Glenn-IT/PCBCES-Plastic-Bottle-Coin-Exchanger-System/docs/chassis_design.html

Mechanical & Industrial Design Specifications

# PCBCES Machine Chassis Concept & Blueprint

Full 3D visualization, internal cutaway anatomy, structural frame blueprint, and fabrication specifications for the Plastic Bottle Coin Exchanger Reverse Vending Kiosk.

← Back to System Hub Electrical Wiring Guide Project Plan Document Arduino Test Suite

🔥

## Machine Visual Presentations & 3D Concepts

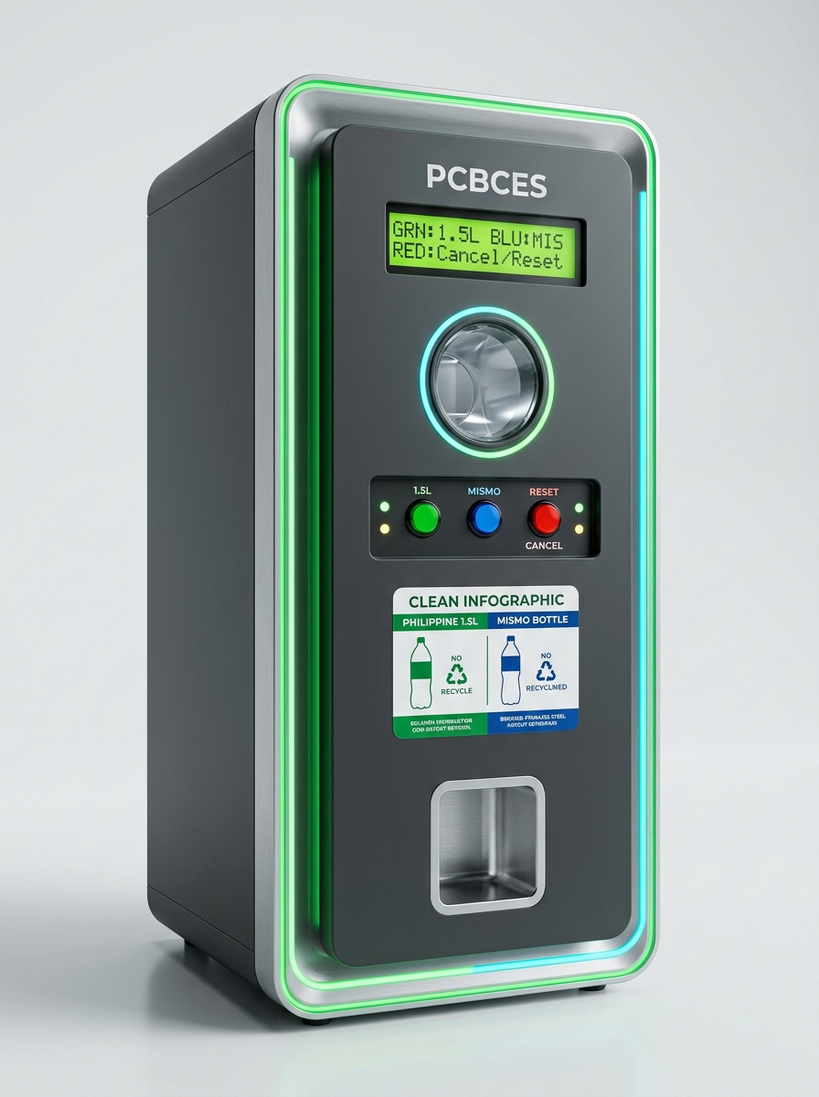
[picture p1: docs/images/pcbces_kiosk_3buttons_1788550020043.jpg]
PCBCES Kiosk Exterior 3-Button Render
Finished Aesthetic (3-Button UI) 

1. Exterior Kiosk Enclosure

Sleek freestanding smart recycling kiosk with dual-tone matte charcoal and brushed aluminum finish. Fitted with eco-friendly LED ring indicators, user prompt screen, and coin retrieval receptacle.

- Overall Size: 120cm (H) × 50cm (W) × 45cm (D)
- Display: 16×2 I2C Backlit LCD Screen
- Input Control: 3× Dedicated Buttons (Green: 1.5L, Blue: Mismo, Red: Reset)
- Intake Ring: 110mm Circular Transparent Port
- Payout Port: Stainless Steel Coin Well

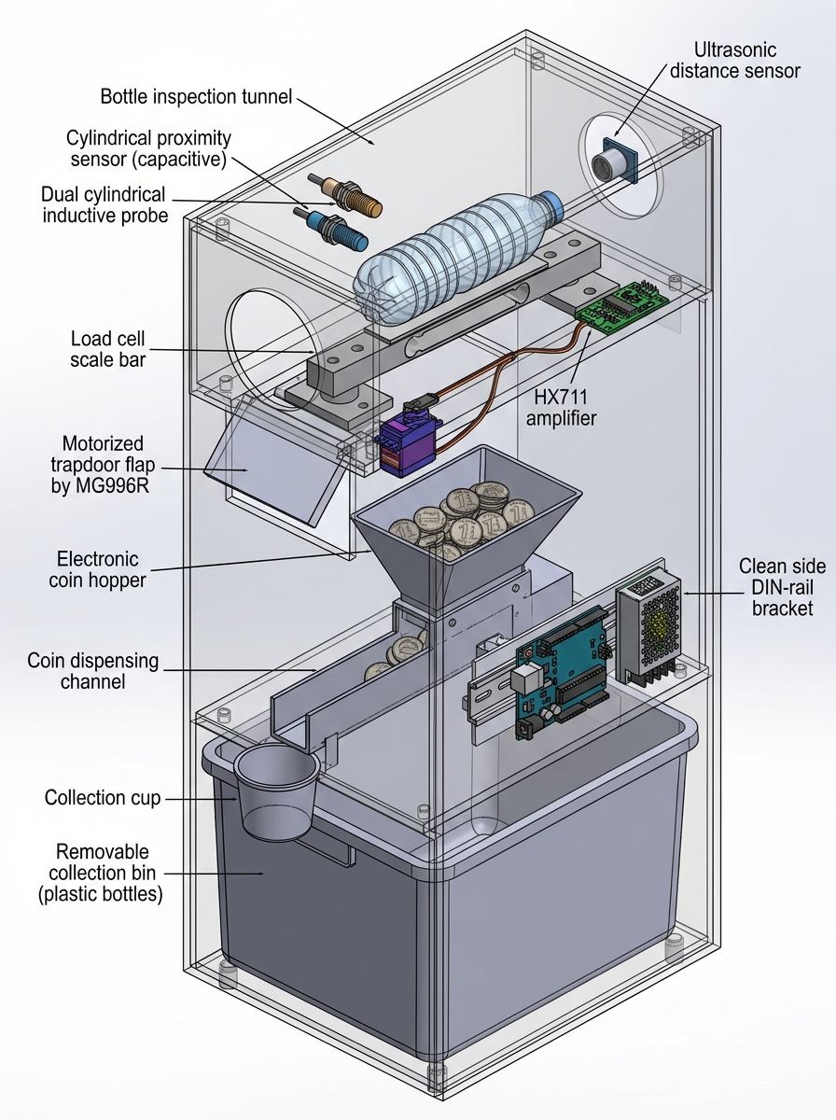
[picture p2: docs/images/pcbces_chassis_cutaway_1788544580664.jpg]
PCBCES Chassis Cutaway Internal Mechanical View
Internal Anatomy 

2. Internal Mechanical Cutaway

Transparent cross-section demonstrating the exact spatial placement of the rigid bottle cradle, non-contact proximity probes, ultrasonic length sensor, MG996R servo trapdoor flap, 12V coin hopper, and controller board.

- Upper Chamber: Non-Contact Sensor Cradle (Length, Metal, Plastic)
- Sorting Flap: MG996R 180° High-Torque Servo Trapdoor
- Coin Dispenser: 12V Motorized Coin Hopper (₱1 Coins)
- Controller: Arduino Uno + LM2596 5V/4V Buck
- Lower Chamber: 30-Bottle High-Capacity Removable Bin

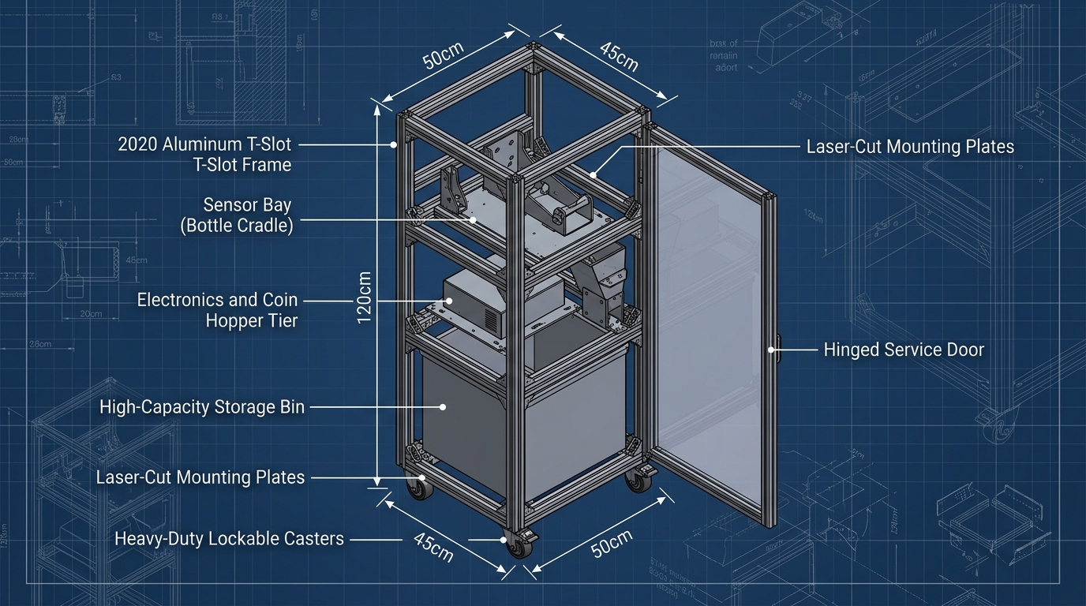
[picture p3: docs/images/pcbces_chassis_frame_1788544600156.jpg]
PCBCES Chassis Frame Blueprint
Structural CAD 

3. Structural Frame & Blueprint

Modular 2020 aluminum T-slot extrusion frame blueprint with laser-cut mounting plates, lockable swivel caster wheels, and front hinged maintenance service door with key cam lock.

- Frame Material: 2020 Aluminum T-Slot / 1/2" Marine Plywood
- Service Access: Full-Height Front Hinged Door
- Mobility: 4× 2-inch Lockable Swivel Casters
- Modular Shelves: 3-Tier Separation Plates
- Cable Trays: Rear Slotted Wire Ducting

📦

## Modular 3-Tier Chassis Architecture

Tier 1 • Top Level (Height: 80cm – 120cm)

### Bottle Inspection Cradle & User Interface

Ergonomically positioned at natural waist-to-chest level for intuitive user operation and clear visibility of the 16×2 instruction screen.

- Bottle Chamber: 43cm vertical chamber with entry guide to support upright bottle placement on the trapdoor.
- Rigid Cradle Mount: Bolted directly to shelf frame with zero fragile deflection points, eliminating mechanical fatigue.
- Proximity Probe: LJ12A3 (Inductive metal sensor) mounted along the chamber wall facing the bottle body for instant metallic object/can rejection. (LJC18A3 capacitive sensor omitted; D5 spare).
- HC-SR04 Ultrasonic: Mounted at the top ceiling (43cm above floor trapdoor) firing downward to measure ceiling-to-bottle cap distance (1.5L/1.7L: 7–15cm, Mismo: 20–27cm).
- MG996R Servo Flap: Bottom trapdoor flap under bottle base. Tilts 90° down to drop accepted bottle into lower bin, or remains closed at 0° for rejection retrieval.

Tier 2 • Mid Level (Height: 45cm – 80cm)

### Coin Hopper & Electronics Control Bay

Secure, dry compartment physically isolated from the bottle dropping path to protect sensitive electronics and coin inventory.

- 12V Coin Hopper: Bolted to mid-shelf with dedicated 45° smooth coin chute feeding down into front retrieval cup.
- Controller Board: Arduino Uno on DIN-rail or standoff mounts with quick-disconnect terminal blocks.
- Dual-Rail Power: S-120-12 (12V 10A PSU) + LM2596 buck converter supplying stable 5.0V (logic) and 4.0V (SIM800L).
- GSM SIM800L Bay: Positioned with external stub antenna away from power transformers to prevent RF noise.

Tier 3 • Base Level (Height: 0cm – 45cm)

### High-Capacity Bottle Collection Bin

Spacious, easily serviceable collection chamber designed to store up to 30–50 empty plastic bottles before requiring emptying.

- Removable Tub: Standard 50-liter plastic tote container with integrated side handles for rapid removal.
- Full Bin Sensing: Upper IR obstacle beam detects when bottles stack up to the ceiling threshold.
- Safety Limit: Firmware software counter halts operation at 30 bottles and triggers SMS alert to the technician.
- Mobility Base: 4× heavy-duty polyurethane caster wheels with dual-locking foot brakes.

📋

## Chassis Fabrication Bill of Materials (BOM)

Item / Material | Specifications / Dimensions | Qty | Category | Purpose
2020 Aluminum T-Slot Extrusions | 20mm × 20mm Anodized (12× 120cm, 8× 50cm, 8× 45cm) | ~14 meters | Structural Frame | Main structural skeleton for lightweight rigid chassis.
Alternative: 1/2" Marine Plywood / MDF | 12mm thickness, 4ft × 8ft sheet (pre-cut panels) | 1 Sheet | Budget Option | Affordable, easy to cut with jigsaw or table saw for school thesis.
Cast Acrylic Sheet (Clear & Smoked) | 4mm / 5mm thickness, laser cut or hand routed | 1 Sheet | Observation & UI | Front window, cradle guide plates, and inspection tunnel.
Continuous Piano Hinge or Butt Hinges | Stainless steel, 60cm length or 3× 3-inch hinges | 1 Set | Hardware | Hinges the front service door for easy maintenance.
Keyed Cam Lock / Flush Latch | Standard arcade / vending cabinet zinc-alloy cam lock | 1 Unit | Hardware | Secures internal coin hopper and electronics from tampering.
Lockable Swivel Caster Wheels | 2-inch / 50mm Polyurethane wheels with brake lever | 4 Units | Hardware | Allows effortless rolling during thesis defense demonstrations.
Stainless Steel Coin Cup Bezel | Arcade coin return chute cup (80mm × 60mm × 45mm) | 1 Unit | UI Hardware | Catches dispensed ₱1 coins from the 12V hopper chute.
V-Groove Bottle Cradle Plates | 3D Printed (PETG) or 5mm bent acrylic cradle | 1 Assembly | Sensor Rig | Rigidly aligns bottles with capacitive, inductive, and ultrasonic sensors.
50-Liter Collection Bin | Standard heavy-duty plastic storage tote (45cm × 35cm × 38cm) | 1 Unit | Storage | Catches accepted bottles falling from the servo trapdoor.

🛠

## Chassis Fabrication & Assembly Sequence

1

#### Frame Assembly

Cut aluminum extrusions (or plywood frame panels). Assemble the rectangular tower box (120cm × 50cm × 45cm) using corner brackets and M5 T-nuts. Bolt the 4 caster wheels to the bottom base plate.

2

#### Partition Shelves

Install the two horizontal dividing shelves: Upper shelf (at 80cm height) for the bottle testing cradle and servo flap; Mid shelf (at 45cm height) for the coin hopper and electronics enclosure.

3

#### Sensor Cradle Rig

Firmly bolt the V-groove bottle cradle to the top shelf. Mount the LJC18 capacitive and LJ12 inductive probes at 8mm distance from the bottle side wall, and the HC-SR04 ultrasonic sensor at the rear stop.

4

#### Servo Trapdoor & Chute

Attach the MG996R metal-gear servo horn to the acrylic trapdoor flap. Verify that when rotating from 0° to 90°, the flap drops the bottle straight into the lower bin without jamming.

5

#### Coin Hopper & Payout

Firmly mount the 12V Coin Hopper. Fasten an inclined PVC or sheet metal coin ramp leading directly from the hopper exit snout down to the front-panel coin retrieval cup.

6

#### Front Panel & UI

Mount the 16×2 I2C LCD, the 3 dedicated push buttons (Green 1.5L, Blue Mismo, Red Cancel/Reset), and status LEDs into laser-cut front door bezels. Connect wiring harnesses with Dupont strain relief.

×
