Glenn-IT/PCBCES-Plastic-Bottle-Coin-Exchanger-System/arduino/Proposal01.png

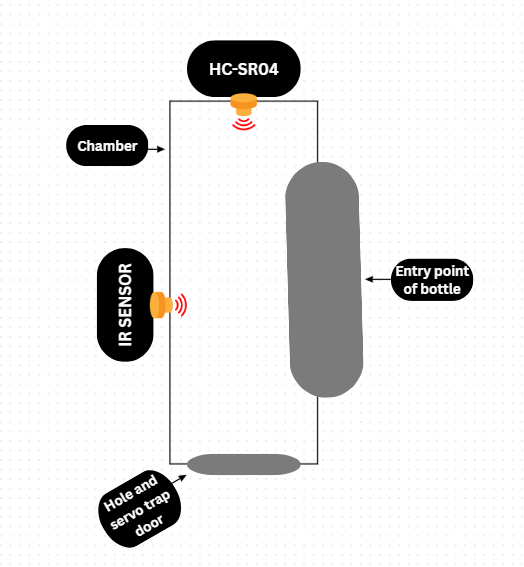
arduino/Proposal01.png
