Glenn-IT/PCBCES-Plastic-Bottle-Coin-Exchanger-System/docs/images/pcbces_fall_mechanism_1788545575948.jpg

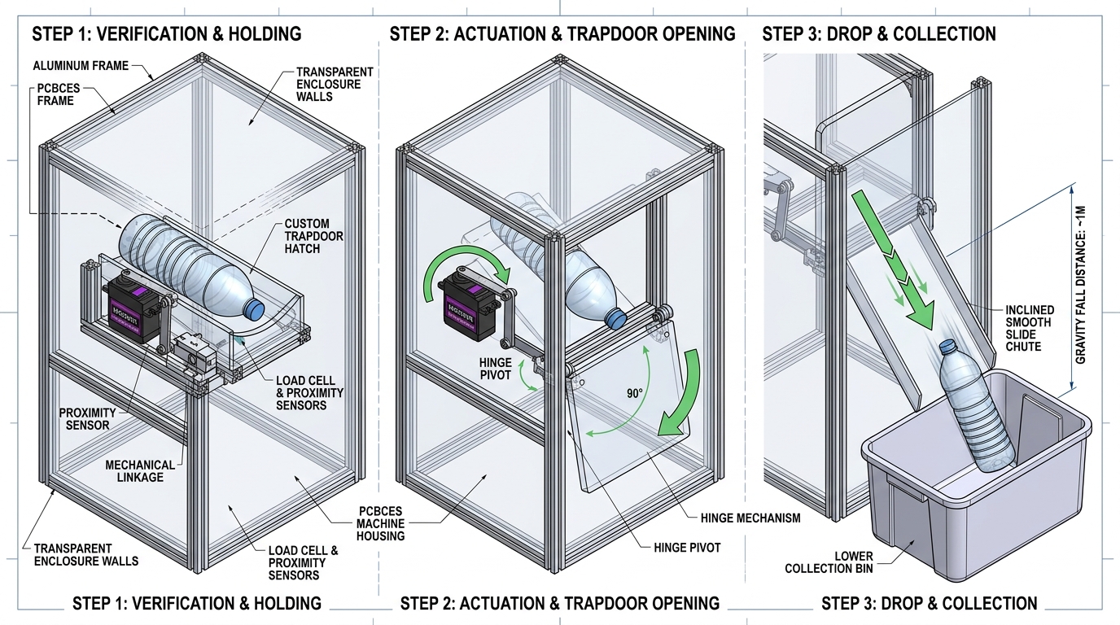
docs/images/pcbces_fall_mechanism_1788545575948.jpg
