Glenn-IT/PCBCES-Plastic-Bottle-Coin-Exchanger-System/docs/images/pcbces_kiosk_render_1788544402479.jpg

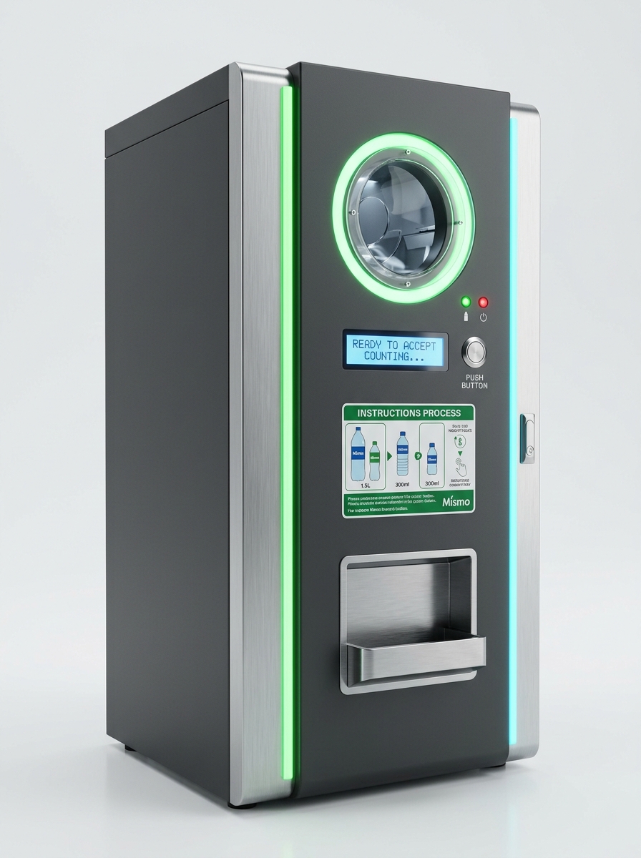
docs/images/pcbces_kiosk_render_1788544402479.jpg
