Glenn-IT/PCBCES-Plastic-Bottle-Coin-Exchanger-System/docs/WIRING_PINOUT.md

# Hardware Wiring & Power Distribution Guide
## PCBCES Capstone Project (with GSM Module)

---

### 1. Power Architecture (CRITICAL)

You have two main power rails + dedicated supply for the GSM module:
1. **12V DC Rail (High Current)**: Supplied by S-120-12 (120W 12V 10A PSU).
   - Powers the **Coin Hopper Motor** (switched via Relay).
   - Powers the **LJ12A3** inductive proximity sensor.
   - Powers the **LM2596 Buck Converter** input.
2. **5V DC Rail (Regulated)**: Supplied by **LM2596 Buck Converter** output (tuned with a multimeter to **5.0V**).
   - Powers **Arduino Uno** (into `5V` pin).
   - Powers **MG996R Servo Motor** (MUST NOT be powered from Arduino 5V board pin; use the 5V bus).
   - Powers **16x2 LCD I2C Backpack**, **HC-SR04**, **IR sensor**, **Buzzer**, and **Relay coil**.
3. **GSM SIM Module Power (SIM900A: 5.0V / SIM800L: 3.7V – 4.4V)**:
   - **DO NOT** connect to Arduino 5V or 3.3V pin (it will drop network or cause Arduino to reboot during SMS transmit).
   - **SIM900A (SIMCom S2-1040U-Z1K0H):** Connect `VCC` directly to the **LM2596 5.0V regulated bus**.
   - **SIM800L:** From the 5V rail, put a **1N4007 Diode** in series (Anode to 5V, Cathode to SIM800L VCC) for ~4.3V.
   - Connect your **1000µF 16V capacitor** directly across module `VCC` and `GND` to supply the 2A instantaneous burst current required for GSM transmission.

> [!IMPORTANT]
> **COMMON GROUND:** The negative (`-V` / `GND`) of the 12V power supply, the output GND of the LM2596 buck converter, the GSM module GND, and all Arduino `GND` pins **MUST be connected together**.

---

### 2. Voltage Divider Wiring (12V Sensors to 5V Arduino)

The `LJ12A3` and the Coin Hopper pulse line output 12V logic. Use two pairs of **10kΩ** and **4.7kΩ** resistors to step the voltage down safely:

```text
Sensor Signal Wire (12V) ───[ 10kΩ Resistor ]───┬───> Arduino Digital Pin (~3.8V safe)
                                                │
                                         [ 4.7kΩ Resistor ]
                                                │
                                             Common GND
```

---

### 3. Complete Step-by-Step Wiring Table

| Component | Pin / Wire | Connects To | Notes |
|---|---|---|---|
| **16x2 LCD (I2C)** | VCC | 5V Bus | From LM2596 5V rail |
| | GND | Common GND | |
| | SDA | Arduino **A4** | Hardware I2C SDA |
| | SCL | Arduino **A5** | Hardware I2C SCL |
| **Button Blue (Mismo / 290 ML)** | Leg 1 | Arduino **A0** | Selects 290 ML mode (10 pcs quota = ₱3.00, `INPUT_PULLUP`) |
| | Leg 2 | Common GND | |
| **Button Red (Reset/Cancel)** | Leg 1 | Arduino **A1** | Cancels transaction / resets system (`INPUT_PULLUP`) |
| | Leg 2 | Common GND | |
| **HC-SR04 Ultrasonic** | VCC | 5V Bus | |
| | GND | Common GND | |
| | Trig | Arduino **D2** | Trigger pulse (Ceiling sensor down into 31cm chamber) |
| | Echo | Arduino **D3** | Echo from bottle cap: 1.5L/1.75L near (11-12cm), 290 ML far (23-24cm) |
| **IR Entry Sensor** | VCC | 5V Bus | Bottle entry detect |
| | GND | Common GND | Ground |
| | OUT | Arduino **D4** | Active LOW when bottle enters cradle |
| **IR Bin-Full Sensor** | VCC | 5V Bus | Bottle storage bin level monitor |
| | GND | Common GND | Ground |
| | OUT | Arduino **D5** | Active LOW when bottle collection bin is full (Triggers SMS) |
| **LJ12A3 Inductive** | Brown (+V) | 12V Rail | |
| | Blue (GND) | Common GND | |
| | Black (Signal) | Voltage Divider (10k/4.7k) -> Arduino **D6** | Metal rejection trigger |
| **Coin Hopper (220V AC / 12V DC)**| Motor Live/VCC | 220V AC Live (or 12V+) via Relay NO contact (Wall Live into COM) | Switched motor power |
| | Motor Neutral/GND| 220V AC Neutral (or Common GND) | Motor return line |
| | Sensor VCC | 5V Bus (YT LP-08 A01 Pin 1) | Optical sensor DC power |
| | Sensor GND | Common GND (YT LP-08 A01 Pin 3) | Optical sensor ground |
| | Sensor Signal | Arduino **D7** (YT LP-08 A01 Pin 2 SIG direct 5V TTL) | 1 pulse = 1 coin dispensed (falling edge) |
| **5V Relay Module** | VCC | 5V Bus | Low voltage logic power |
| | GND | Common GND | Low voltage ground |
| | IN | Arduino **D8** | Relay trigger (Active LOW) |
| **MG996R Servo** | Red (+V) | 5V Bus (with 1000µF capacitor across + & -) | High torque servo |
| | Brown (GND) | Common GND | |
| | Orange (Signal)| Arduino **D9 (PWM)** | Controls trapdoor gate (0° Standby / Reject, 90° Accept Drop) |
| **Button Green (1.5L)** | Leg 1 | Arduino **D10** | Selects 1.5L / 1.75L mode (5 pcs quota = ₱20.00, `INPUT_PULLUP`) |
| | Leg 2 | Common GND | |
| **GSM Module (SIM900A / SIM800L)** | VCC | 5V Bus (SIM900A) / 4.3V Rail (SIM800L) + 1000µF cap | 2A burst current capable |
| | GND | Common GND | Common system ground |
| | 5VT / SIM TX | Arduino **D11 (SoftwareSerial RX)** | Receives AT responses |
| | 5VR / SIM RX | Arduino **A3 (SoftwareSerial TX)** | Sends AT commands |
| **Active Buzzer** | Positive (+) | Arduino **D12** | Active buzzer beeps when HIGH |
| | Negative (-) | Common GND | |
| **Red Light / LED** | Anode (+) | Arduino **D13** (via 220Ω resistor) | Rejection indicator |
| | Cathode (-) | Common GND | |
| **Green Light / LED** | Anode (+) | Arduino **A2** (via 220Ω resistor) | Acceptance indicator |
| | Cathode (-) | Common GND | |

---

### 4. GSM SIM Module Operating Tips for Philippines (PH)

1. **SIM Card Type:** Use a standard **Smart / TNT** or **Globe / TM** prepaid nano/micro SIM with an adapter.
2. **SIM Load:** Ensure the SIM has at least ₱10–₱20 regular load or an active unli-text promo so AT commands can successfully dispatch SMS.
3. **Network LED Indicator on SIM Module:**
   - Fast blink (every 1 sec): Searching for 2G network.
   - Slow blink (every 3 sec): Successfully registered to network! (Ready to send SMS).
