Glenn-IT/PCBCES-Plastic-Bottle-Coin-Exchanger-System/docs/wiring_guide.html

Capstone Hardware Engineering Reference

# PCBCES Full System Hardware Wiring & Schematic Hub

Plastic Bottle Coin Exchanger System with 12V High-Torque Hopper (₱20 / ₱3 Payout), Multi-Sensor Bottle Classifier (1.5L/1.75L vs 290 ML), Dedicated 3-Button User Interface (Green 1.5L / Blue 290 ML / Red Reset), and SIM800L GSM Bin-Full SMS Dispatcher.

⚡ Master Dual-Rail (12V & 5V) Power & Star Ground Architecture

High-current inductive loads (Coin Hopper motor & MG996R servo) are strictly isolated with dedicated 1000µF decoupling capacitors and a 1N4007 flyback diode. Sensor inputs from 12V proximity switches are scaled via 10kΩ/4.7kΩ voltage dividers to safeguard the Arduino Uno's ATmega328P.

🔴 12V 10A Main PSU 🟠 LM2596 5.00V Buck 🟡 4.3V Diode/Cap GSM Rail 🟢 I2C LCD (2 Pins Only) 🔵 100% Star Ground

🎛️

Interactive Circuit Subsystem Filter

Select subsystems to highlight or isolate specific wires, components, and signal paths on the master schematic below.

🔬 Bottle Sensors Only 🪙 Coin Hopper & Relay 📱 GSM & Bin Full Alert ✨ Show All (Reset)

⚡ 12V & 5V Dual Power Rails 🔬 Bottle Sensors (HC-SR04, IR, Proximity) 🪙 Coin Hopper & 5V Relay (220V AC / 12V DC) ⚙️ MG996R Trapdoor Sorting Servo 📱 SIM800L GSM SMS Module 📟 16x2 I2C LCD, Button, Buzzer & LEDs

Showing 6 of 6 Active Subsystems

📐

Full System Circuit Schematic Diagram (High-Visibility Vector SVG)

Arduino Uno R3 • 20 Total Pins Utilized

📋

Complete Arduino Uno Pin Assignment Matrix

Pin | Device / Subsystem | Signal / Voltage | Function
D0 / D1 | USB Hardware Serial | 5V TTL / USB | Kept free for PC Debugging & XAMPP serial bridge
D2 | HC-SR04 Ultrasonic | Digital Output (5V) | Trigger pulse (Ceiling sensor down into 43cm chamber)
D3 | HC-SR04 Ultrasonic | Digital Input (5V) | Echo duration to bottle cap: 1.5L/1.75L near (7-15cm), 290 ML far (26-27cm)
D4 | IR Obstacle Sensor | Digital Input (5V) | Active LOW when bottle is inserted in slot
D5 | IR Bin-Full Sensor | Digital Input (5V) | Detects when bottle storage bin is full & triggers SIM800L SMS alert
D6 | LJ12A3 Inductive Sensor | Digital In via 10k/4.7k | Metal proximity sensor (Triggers instant rejection)
D7 | Coin Hopper Pulse Counter | Digital In (5V TTL or ~3.8V via divider) | Falling pulse counter (1 pulse = 1 dispensed coin)
D8 | 5V Relay Module | Digital Output (5V) | Switches 220V AC Live (or 12V DC) to Hopper motor
D9 | MG996R Servo Motor | PWM Output (5V) | Trapdoor sorting gate: 0° Standby / Reject, 90° Accept Drop
D10 | Button Green (1.5L) | Digital In (PULLUP) | Direct selection for 1.5L / 1.75L Mode (5 pcs quota = ₱20.00)
D11 | SIM800L GSM Module | SoftwareSerial RX | Receives AT command responses from SIM TX
D12 | Active Buzzer Module | Digital Output (5V) | Beeps: Success chime vs Rejection alarm
D13 | Red Indicator LED | Digital Output (5V) | Visual rejection & system error alert
A0 | Button Blue (Mismo / 290 ML) | Digital In (PULLUP) | Direct selection for 290 ML Mode (10 pcs quota = ₱3.00)
A1 | Button Red (Cancel/Reset) | Digital In (PULLUP) | Cancels current transaction, resets count & restarts
A2 | Green Indicator LED | Digital Output (5V) | Visual acceptance & ready status
A3 | SIM800L GSM Module | SoftwareSerial TX | Sends AT SMS dispatch commands to SIM RX
A4 | 16x2 LCD (PCF8574) | Hardware I2C SDA | Screen data communication
A5 | 16x2 LCD (PCF8574) | Hardware I2C SCL | Screen clock synchronization

🛡️

Safety Checklist & Safe Power-Up Sequence

⚠️

#### Do NOT Power SIM800L or MG996R from Arduino 5V Pin!

The Arduino Uno onboard 5V regulator can only output ~400mA. The MG996R servo draws up to 1.5A peak and the SIM800L draws 2A bursts during transmission. Always power them from the LM2596 5V rail backed by the 1000µF capacitor!

⚡

#### Voltage Divider Verification Required

Before connecting D5, D6, and D7 to the Arduino, measure the signal wire with your multimeter. With a 10kΩ and 4.7kΩ divider, the voltage must read between 3.6V and 4.0V (safe for Arduino). Never feed raw 12V into an Arduino pin.

#### Step 1: Tune LM2596 Output Voltage

1. Connect S-120-12 PSU to AC mains. Turn the brass potentiometer screw on the LM2596 until your multimeter reads exactly 5.00V DC across OUT+ and OUT-.

#### Step 2: Establish Central Star Ground

2. Tie PSU (V-), Buck (OUT-), GSM GND, and Arduino GND into one solid common breadboard rail. This eliminates floating ground noise.

#### Step 3: Wire Resistor Dividers for 12V Signals

3. Build two identical 10kΩ/4.7kΩ voltage divider pairs on the breadboard for the LJ12A3 Inductive metal sensor and the Coin Hopper pulse wire. (LJC18A3 is omitted; Pin D5 is spare).

#### Step 4: Connect I2C LCD & Calibrate Contrast

4. Wire SDA to A4 and SCL to A5. Adjust the small blue potentiometer on the back of the I2C backpack until clear white characters appear on the blue screen.

#### Step 5: Test GSM SMS Dispatch

5. Insert active SIM card. Verify that the SIM module netlight transitions from fast blinking (1/s) to slow blinking (every 3s), indicating network registration.
