Glenn-IT/PCBCES-Plastic-Bottle-Coin-Exchanger-System/arduino/05_mg996r_servo_trapdoor_test/wiring_guide.html

Isolated Bench Test 05

# MG995 Metal Gear Sorting Trapdoor Mechanism

Hardware: TowerPro MG995 High-Torque Servo • D9 (PWM) • LM2596 5V Rail • 1000µF 16V–50V Decoupling Buffer

🏠 Master Hub Test 01: LCD & 3-Button Test 02: Weight (Archived) Test 03: Height & Entry Test 04: Metal Sensor Test 05: Servo Trapdoor (MG995) Test 06: Coin Hopper Test 07: GSM SMS Alert Test 08: Hopper + GSM Alert 🚀 Full Controller

🔍

MG995 Servo Specifications & 1000µF 50V Capacitor Compatibility

Orange / White Wire

PWM Signal (D9)

5V PWM timing pulse from Arduino Uno Pin D9 controlling angles: 0° Standby / Reject Hold, 90° Accept Drop.

Red Wire (+)

+5.0V Buck Rail

Powers motor & gear train. Connects to LM2596 5.0V rail (NEVER Arduino 5V pin!).

Brown / Black Wire (-)

Common Star GND

Ground return line. Must share common ground with Arduino Uno GND.

Peak Inrush Current

1.5A – 2.0A Peak

High-torque metal gears moving under bottle load draw sudden current spikes when accelerating.

Motor Model

TowerPro MG995

High-Torque Metal Gear Servo (fully backwards-compatible drop-in with MG996R).

Stall Torque

8.5 – 10.0 kg·cm

Rated at 4.8V–6.0V. Provides strong retention torque for trapdoor gate control.

Operating Speed

0.20s / 60° (at 4.8V)

Swift 90° rotation in ~300ms to instantly drop accepted bottle into internal bin.

Dead Bandwidth

~5 µs

Standard servo deadband. Keep resting ledge installed at 0° to avoid continuous holding strain.

#### ✅ Can I use my 1000µF 50V Electrolytic Capacitor? YES, 100% PERFECT!

A 1000µF 50V capacitor is completely compatible and safe for your 5V servo power rail. Here is why:

- 1000µF Capacitance: This is the exact reservoir size needed to store charge and instantly feed the servo's 2.5A startup spikes, completely eliminating voltage dips (brownouts) that would cause the Arduino Uno to reboot.
- 50V Voltage Rating: The 50V printed on the capacitor is its maximum breakdown limit. When used on a 5.0V rail, it operates with a 10x safety headroom. It will run cool, experience zero electrical stress, and last virtually forever! (Any rating ≥ 10V, 16V, 25V, 35V, or 50V works identically).
- POLARITY CHECK: Ensure the negative leg (shorter leg with white stripe and minus − signs) connects to GND, and the positive leg (longer leg) connects to +5V.

⚡

Interactive Wiring Schematic (MG995, 1000µF Buffer, & Arduino Uno)

📋

Complete Hardware Interconnection Matrix

Hardware & Lead | Wire Color | Connected Destination | Voltage Domain | Electrical Function
Servo PWM Signal | Orange / White | Arduino Uno Pin D9 | 5V PWM Logic | Angle position timing command (0° Standby / Reject Hold, 90° Accept Drop)
Servo Motor Power (+) | Red Wire | LM2596 5.0V Buck Rail | 5.0V DC (1.5A–2.0A) | Dedicated regulated power for high-torque servo motor and gearbox
Servo Motor Ground (-) | Brown / Black | Common Star GND | 0V Ground | Power and signal ground return path
1000µF Capacitor (+) | Longer Leg | LM2596 5.0V Buck Rail | 5.0V DC (50V max) | Energy buffer: Supplies rapid current bursts during servo motor acceleration
1000µF Capacitor (-) | Shorter Leg (Stripe) | Common Star GND | 0V Ground | Capacitor ground connection (Observe polarity!)
Arduino Uno Ground | Black Wire | Common Star GND | 0V Ground | Ensures common ground reference between Arduino PWM and 5V power rail

⚖

Trapdoor Sorting Positions & Angular Motion Standard

Position Command | Servo Angle | Mechanical Flap State | Action on Inserted Item | System State Context
Standby / Closed | 0° | 100% Horizontal Flat | Supports inserted bottle on cradle under sensor inspection | STATE_STANDBY / WAITING
Accept / Drop | 90° | Swings Downward Open | Drops valid plastic bottle into internal storage bin under gravity, then returns to 0° Standby | STATE_ACCEPT_DROP
Reject / Hold | 0° | Stays at 0° (Closed Flap) | Keeps invalid item (metal can, wrong size) on cradle for customer manual retrieval from entry chute | STATE_REJECT_EJECT

#### ⚠ CRITICAL CHASSIS MECHANICAL WARNING:

- Provide a mechanical resting ledge under the flap at 0°! A full 1.5L bottle filled with liquid weighs ~1.5 kg. Never allow that entire weight to hang solely on the servo internal metal gear spline. A small physical shelf or stop beneath the flap will absorb the impact force, prevent gear wear, and eliminate any 5µs deadband motor buzz.
- Never power the servo from Arduino 5V pin! The onboard Arduino 5V regulator can only provide ~400mA, but the MG995 pulls up to 2.0A during sudden moves. Powering it from the Arduino will instantly brown out and reboot the microcontroller.

✅

Step-by-Step Bench Testing Procedure (Supports 360° Continuous & 180° Positional)

1

#### Calibrate 5.0V Buck Rail

Turn on the 12V PSU. Using your Digital Multimeter, measure the output of your LM2596 buck converter. Turn the gold trimmer screw until the output reads exactly 5.00V ± 0.1V.

2

#### Install 1000µF 50V Capacitor

Insert the 1000µF 50V capacitor directly across the breadboard 5V and GND power rails right next to the servo connection. Verify the white stripe side with minus − signs is plugged into GND!

3

#### Upload Timed Control Sketch

Upload 05_mg996r_servo_trapdoor_test.ino to Arduino Uno. On startup, the firmware sends write(90) immediately so the 360° motor halts in place without spinning continuously!

4

#### Interactive Serial Testing

Open Serial Monitor at 115200 baud. Type 1 to execute a full timed drop cycle (opens for 300ms, waits 1.5s, reverses for 300ms to close). Use + or - to calibrate timing!

#### 🔧 360° Continuous Servo Control Standard:

- write(90) = STOP (Neutral): Cuts motor drive. Always sent on startup and between actions.
- write(70) = OPEN: Drives motor forward for configured duration (default: 300ms for ~90° swing).
- write(110) = CLOSE: Drives motor in reverse for configured duration back to horizontal resting position.
- + and - Tuning: Adjust pulse duration in 50ms increments to achieve the exact flap open angle.

#### Expected Serial Monitor Output (115200 baud):

==================================================
PCBCES Test 05: MG995 360° Continuous Trapdoor
==================================================
Motor Status: STOPPED (Neutral 90 sent)
Current Rotation Pulse Duration: 300 ms
Commands:
'1' -> Full Drop Cycle (Open -> Wait 1.5s -> Close)
'o' -> Test OPEN pulse
'c' -> Test CLOSE pulse
's' -> Emergency STOP (write 90)
'+' -> Increase pulse duration (+50ms)
'-' -> Decrease pulse duration (-50ms)
==================================================
[ACTION] Triggering Full Bottle Acceptance Drop...
-> Opening flap (driving for 300 ms)...
-> Open motion finished. Motor stopped.
-> Waiting 1.5s for bottle to drop under gravity...
-> Closing flap (driving reverse for 300 ms)...
-> Close motion finished. Flap locked at stop.
[CYCLE COMPLETE] Ready for next bottle.
