Glenn-IT/PCBCES-Plastic-Bottle-Coin-Exchanger-System/arduino/03_ultrasonic_ir_dimension_test/wiring_guide.html

Component Bench Test 03

# Ultrasonic HC-SR04 & IR Entry Sensor Test

Hardware: HC-SR04+ Ultrasonic Transceiver (D2/D3) • IR Obstacle Entry Sensor (D4) • Arduino Uno R3

← Master Hub Test 01: LCD & 3-Buttons Test 02: Weight (Archived) Test 03: Height & Entry Test 04: Metal / Plastic Test 05: Servo Trapdoor Test 06: Coin Hopper Test 07: GSM SMS Alert Test 08: Hopper + GSM Alert Master Controller

👁

Visual Workbench Presentation & Real Hardware Setup

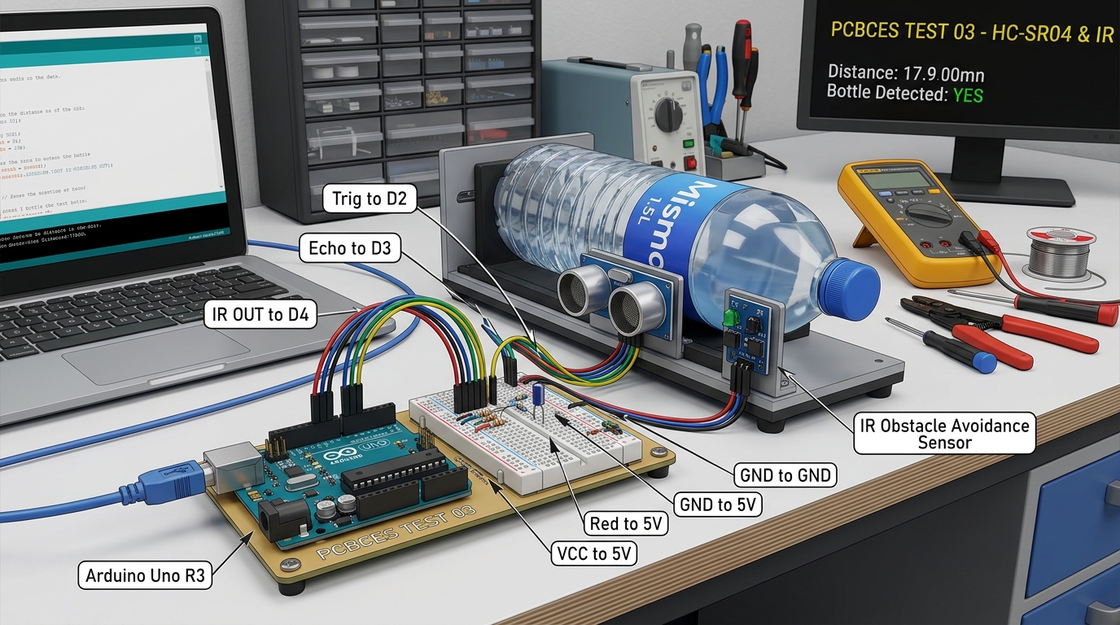
[picture p7: arduino/03_ultrasonic_ir_dimension_test/test03_visual.jpg]
PCBCES Test 03 Workbench 3D Visual Render
Click to Enlarge 3D Setup 

This bench setup validates your Vertical Drop Chamber (31 cm physical height from bottom trapdoor to ceiling sensor). The HC-SR04 ultrasonic transceiver is mounted at the top ceiling looking down at the bottle cap. A tall 1.5L / 1.75L bottle leaves a short distance of 11 cm to 12 cm to the ceiling. A shorter 290 ML bottle sits lower down, measuring 23 cm to 24 cm to the ceiling. The IR obstacle sensor is mounted on the entry wall to immediately wake up scanning when a bottle is inserted.

📋

Complete Hardware Pin Connection Matrix

Sensor Module | Module Pin | Arduino Uno Pin | Wire Color | Electrical Signal & Function
HC-SR04 Ultrasonic | VCC | 5V Pin | Red | 5V DC Power
HC-SR04 Ultrasonic | GND | GND Pin | Black | Ground Reference
HC-SR04 Ultrasonic | Trig | Arduino D2 | Yellow | 10µs ultrasonic start pulse (Digital Output)
HC-SR04 Ultrasonic | Echo | Arduino D3 | Green | Ceiling-to-bottle cap return pulse (Digital Input)
IR Obstacle Sensor | VCC | 5V Pin | Red | 5V DC Power
IR Obstacle Sensor | GND | GND Pin | Black | Ground Reference
IR Entry Sensor | OUT | Arduino D4 | White / Purple | Active LOW signal: 0V when bottle enters chamber, 5V when clear
IR Bin-Full Sensor | OUT | Arduino D5 | Orange / White | Active LOW signal: 0V when bottle storage bin is full (triggers SMS)

⚡

Interactive Circuit Schematic

✅

Bench Testing & Calibration Procedure

1

#### Verify 5V Logic

Ensure the HC-SR04+ and IR sensor are connected to the 5V regulated rail and share a common ground with the Arduino Uno.

2

#### Flush Mount & Calibrate IR Sensor

Mount the IR sensor body outside the chamber with lens flush to the wall (do NOT let the sensor head protrude into the 15°–30° ultrasonic cone). Calibrate the potentiometer screw so the onboard LED lights ONLY when an object is in the entry chute.

3

#### Upload Sketch

Open 03_ultrasonic_ir_dimension_test.ino in Arduino IDE. Select Tools → Board → Arduino Uno, select your COM port, and click Upload.

4

#### Open Serial Monitor

Open Serial Monitor and set baud rate to 115200 baud. Place a 1.5L bottle and then a 290 ML bottle in the vertical chamber to watch the live classification stream.

#### Expected Serial Monitor Output (31 cm Vertical Chamber):

==========================================================
PCBCES Test 03: Height & Dual IR Sensors (Entry & Bin)
Total Height: 31 cm (Ceiling Sensor to Base Trapdoor)
Pins: D2 Trig | D3 Echo | D4 IR Entry | D5 IR Bin Full
==========================================================
IR Entry (D4): [CLEAR ] | Bin Full (D5): [CLEAR ] | Cap Dist: 31 cm | Waiting for bottle insertion...
IR Entry (D4): [BOTTLE PRESENT] | Bin Full (D5): [CLEAR ] | Cap Dist: 11 cm | 1.5L / 1.75L BOTTLE DETECTED (NEAR)
IR Entry (D4): [BOTTLE PRESENT] | Bin Full (D5): [CLEAR ] | Cap Dist: 23 cm | 290 ML BOTTLE DETECTED (FAR)
IR Entry (D4): [CLEAR ] | Bin Full (D5): [BIN FULL!] | Cap Dist: 31 cm | Waiting for bottle insertion...

×
