Glenn-IT/PCBCES-Plastic-Bottle-Coin-Exchanger-System/arduino/02_load_cell_hx711_test/wiring_guide.html

ARCHIVED / OMITTED TEST 02

# HX711 Load Cell Weight Calibration [Retired]

Hardware: 1kg Aluminum Straight Bar Load Cell • HX711 24-Bit ADC Module (Bench Isolated)

🏠 Master HubTest 01: LCD & ButtonTest 02: Weight (HX711)Test 03: Height & EntryTest 04: Metal / PlasticTest 05: Servo TrapdoorTest 06: Coin HopperTest 07: GSM SMS AlertTest 08: Hopper + GSM Alert🚀 Full Controller

### ⚠️ Architecture Notice: Omitted from Master Machine

The HX711 load cell was retired in favor of non-contact ultrasonic bottle height discrimination and capacitive dielectric plastic verification. In the active master machine, Pin A0 is reallocated to Button Blue (Mismo Mode - 10 pcs) and Pin A1 is reallocated to Button Red (System Restart / Cancel). This guide remains available strictly for bench calibration reference.

⚖️

Interactive Wiring Schematic (HX711 & 1kg Load Cell)

📋

Wiring Color Codes (HX711 to Load Cell Bar)

Load Cell Wire Color | Connects to HX711 Terminal | Signal Meaning
Red Wire | E+ (Excitation +) | Positive Bridge Voltage (~4.3V)
Black Wire | E- (Excitation -) | Ground Reference
White Wire | A- (Signal -) | Differential Signal Negative
Green Wire | A+ (Signal +) | Differential Signal Positive
