Glenn-IT/PCBCES-Plastic-Bottle-Coin-Exchanger-System/arduino/06_coin_hopper_relay_test/wiring_guide.html

Isolated Bench Test 06

# 220V Coin Hopper & 5V Relay Payout Controller

Complete AC Mains Wall Plug • 5V Relay Switching (COM/NO) • 5V YT LP-08 A01 Optical Pulse Counting (D7) • Zero False-Count Edge Polling

🏠 Master Hub Test 01: LCD & 3-Button Test 02: Weight (Archived) Test 03: Height & Entry Test 04: Metal Sensor Test 05: Servo Trapdoor Test 06: Coin Hopper Test 07: GSM SMS Alert Test 08: Hopper + GSM Alert 🚀 Full Controller

🔍

220V Coin Hopper & Sensor Board Hardware Specifications

220V Motor Power

220V AC Mains

Thick Brown (Live) & Blue (Neutral) wires at motor rear. Switched safely via 5V Relay module (COM & NO).

5V Relay Module

10A 250VAC Rated

Songle relay contacts isolate 220V AC from Arduino 5V logic. Active LOW trigger on Pin D8.

Sensor Board Power

+5V DC Regulated

Board: YT LP-08 A01. Pin 1 (VCC) & Pin 3 (GND) connect to Arduino 5V and common ground rail.

Coin Pulse Output

Direct 5V Logic (D7)

Pin 2 (SIG) connects directly to Arduino D7. Active LOW falling edge when a coin breaks the optical beam.

#### 💡 Direct 5V Sensor Interfacing (No Resistor Divider Needed):

Because the `YT LP-08 A01` sensor board is powered by the 5V DC rail (from your Arduino/breadboard), its Pin 2 (SIG) output signal is already clean 5.0V TTL logic! It connects directly into Arduino Pin D7 with internal pullup enabled (INPUT_PULLUP).

⚡

Interactive Wiring Schematic (220V AC Wall Plug, 5V Relay, Hopper & Arduino Uno)

📋

Complete Hardware Interconnection Matrix

Subsystem / Device | Wire / Terminal | Color Code | Connected Destination | Voltage / Signal Domain | Purpose & Function
220V Wall Plug | LIVE (Hot) | Brown / Black | Relay COM Terminal | 220V AC Mains (Hot) | High-voltage AC supply feed into relay contact
220V Wall Plug | NEUTRAL | Blue / White | Hopper Motor BLUE Wire | 220V AC Return | Insulated joint with electrical tape / wire nut
5V Relay Module | COM | Screw Terminal | 220V AC Live Wire | 220V AC Mains | Input contact from AC wall plug
5V Relay Module | NO (Normally Open) | Screw Terminal | Hopper Motor BROWN Wire | Switched 220V AC | Supplies 220V to motor only when relay is energized
5V Relay Module | VCC | Orange Jumper | Breadboard 5V Rail | +5.0V DC Regulated | Powers relay coil and optocoupler circuit
5V Relay Module | GND | Black Jumper | Common Star GND | 0V Ground | Coil ground return
5V Relay Module | IN | Pink Jumper | Arduino Uno Pin D8 | 5V TTL Logic | Active LOW trigger: LOW = Relay ON, HIGH = Relay OFF
Sensor Board (YT LP-08) | Pin 1 (VCC) | Red Jumper | Breadboard 5V Rail | +5.0V DC Regulated | Powers optical sensor and infrared transmitter
Sensor Board (YT LP-08) | Pin 2 (SIG) | Purple Jumper | Arduino Uno Pin D7 | 5.0V / 0V TTL Logic | Clean pulse input (Falling edge triggers 1 coin count)
Sensor Board (YT LP-08) | Pin 3 (GND) | Black Jumper | Common Star GND | 0V Ground | Ground reference for optical sensor

⚖

Optical Pulse Logic & System Payout Standards

#### A. Optical Sensor Output Signal States:

Hopper State | Optical Exit Path | Board Red LED | Arduino Pin D7 State | Firmware Detection Logic
Idle / Motor Spinning | Infrared Beam Unbroken | OFF | HIGH (~5.0V) | Idle baseline (No pulse counted)
Coin Exiting Chute | Coin Blocks Infrared Beam | FLASHES ON (Red) | FALLING → LOW (~0V) | Single Falling Edge: coinsDispensed++

#### B. Capstone Reverse Vending Machine Payout Quotas:

Bottle Mode | Hardware Selection | Deposit Quota | Reward Payout | Coins Counted (D7) | Serial Test Key
1.5L / 1.75L Bottle Mode | Button Green (D10) | 5 bottles (0/5) | ₱20.00 (₱4.00/pc) | 20 Coins | Send 2
290 ML Bottle Mode | Button Blue (A0) | 10 bottles (0/10) | ₱3.00 (~₱0.30/pc) | 3 Coins | Send 1 or d

#### ⚠ CRITICAL 220V MAINS SAFETY RULES:

- Unplug Before Touching: Always disconnect the 220V wall plug from the outlet before touching any relay terminal screws or motor wires!
- Insulate Exposed Wires: The connection between the 220V Neutral wire and the hopper Blue wire carries live return current. Wrap it thoroughly with electrical tape or a screw-on wire nut.
- No Metal Contact Under Relay: Keep the bottom of the 5V relay module resting on wood, plastic, or thick cardboard so the 220V solder traces cannot touch any metal chassis or breadboard pins.
- 5-Second Dry-Run Auto-Cutoff: If the hopper runs empty or jams, the firmware automatically cuts relay power after 5 seconds of no detected coin pulses to protect the motor from running dry.

✅

Step-by-Step Automated Payout Testing Procedure

1

#### Verify 5V DC Sensor Connections

Ensure Sensor Pin 1 (VCC) is connected to the 5V rail, Pin 3 (GND) to GND rail, and Pin 2 (SIG) to Arduino Pin D7. Slide switch on board is set to BIG.

2

#### Secure 220V Screw Terminals

With the 220V plug UNPLUGGED, screw the AC Live wire into Relay COM and the Hopper Brown wire into Relay NO. Join AC Neutral to Hopper Blue with electrical tape.

3

#### Load Coins & Plug In 220V Cord

Place 10 to 15 clean ₱1 coins into the hopper bowl. Place a catch tray under the chute. Now plug the 220V cord into the wall outlet. Motor stays OFF because Relay is inactive.

4

#### Trigger Payout via Serial Monitor

Open Serial Monitor at 115200 baud. Send 1 to dispense 3 coins. The relay clicks ON, motor spins, dispenses coins, counts live, and clicks OFF instantly at 3!

#### Expected Serial Monitor Output (115200 baud):

==================================================
PCBCES Test 06: Coin Hopper Payout Testing
Hardware: Pin D8 (Relay) | Pin D7 (Coin Pulse)
==================================================
Initial Pin D7 State: HIGH
Commands:
'1' or 'd' -> Dispense 3 Coins (3.00 PHP - 290 ML Quota)
'2' -> Dispense 20 Coins (20.00 PHP - 1.5L/1.75L Quota)
--------------------------------------------------

>>> STARTING PAYOUT: Target = 3 Coins (3.00 PHP)
>>> Relay ON -> Waiting for coins...
--> [COIN DETECTED!] Count = 1 / 3
--> [COIN DETECTED!] Count = 2 / 3
--> [COIN DETECTED!] Count = 3 / 3

==================================================
>>> PAYOUT COMPLETE! Total Coins Counted: 3
>>> Relay OFF -> Motor Stopped.
==================================================
Send '1' to dispense 3 coins, or '2' to dispense 20 coins:
