Glenn-IT/PCBCES-Plastic-Bottle-Coin-Exchanger-System/arduino/08_coin_hopper_gsm_low_coin_test/wiring_guide.html

Component Test 08

# Coin Hopper & GSM SMS Low-Coin / Jam Alert System

Integration Test: 12V Coin Hopper • 5V Relay (D8) • Pulse Optical Counter (D7) • SIM900A / SIM800L (D11/A3) • 5-Second Dry-Run Cutoff & Automated SMS Alert

🏠 Master Hub Test 01: LCD & Button Test 02: Weight (HX711) Test 03: Height & Entry Test 04: Metal / Plastic Test 05: Servo Trapdoor Test 06: Coin Hopper Test 07: GSM SMS Alert Test 08: Hopper + GSM Alert 🚀 Full Controller

Hopper Actuator

5V Relay (Pin D8)

Active LOW • Switches 12V DC / 220V AC to Hopper Motor

Coin Counter Sensor

Optical Pulse (Pin D7)

Falling Edge • 1 Pulse = ₱1.00 • 35ms Lockout Debounce

Safety Timeout Threshold

5.0 Seconds

Auto-halts motor if no coin passes within 5000 ms

Autonomous SMS Dispatch

SIM900A / SIM800L

5VT → D11 RX | 5VR ← A3 TX • Emergency Empty Alert

⚡

Interactive Integrated Circuit Schematic — Coin Hopper & GSM Dispatcher

🔌

Pin Connection & Wiring Matrix

Subsystem Device | Module Pin | Arduino Uno Pin | Voltage / Signal Domain | Wire Color | Functional Purpose
5V Relay Module | IN | D8 | 5V Digital Output | Purple | Active LOW trigger: Starts/Stops coin hopper motor
Coin Hopper Optical Sensor | SIG (YT LP-08 Pin 2) | D7 | 5V TTL Logic (Active LOW) | Cyan / Blue | Optical falling-pulse interrupt line (1 falling edge = ₱1 dispensed)
SIM900A GSM Module | 5VT (Module TX) | D11 | 5V TTL Serial | Yellow | SoftwareSerial RX ← Receives AT responses from GSM modem
SIM900A GSM Module | 5VR (Module RX) | A3 | 5V TTL Serial | Blue | SoftwareSerial TX → Transmits AT SMS commands to GSM modem
Active 5V Buzzer | Positive (+) | D12 | 5V Digital Output | Orange | Single beep on pulse; Triple alarm chirp on 5-second timeout
Red Status LED | Anode (+) | D13 | 5V Digital Output (via 220Ω) | Red | Visual fault indicator: Latches ON when hopper times out

🛡️

Autonomous Protection & Emergency SMS Telemetry Logic

01

#### Payout Trigger

User deposits bottle quota (or tester sends '1' or '2'). Relay turns ON (Pin D8 LOW), initiating rotation of the coin dispensing disc.

02

#### Pulse Monitoring & Timer Reset

Every coin passing through the optical slot triggers an active LOW pulse on D7. Each detected pulse increments the coin tally and resets the safety timer to 0 ms.

03

#### 5-Second Timeout Check

If 5000 ms elapses without a single coin pulse (e.g. hopper is empty or coins are jammed in the chute), the firmware instantly halts the motor (Pin D8 HIGH).

04

#### Automated SMS Dispatch

The Arduino commands the SIM900A module via AT commands to send an urgent SMS: "ALERT: PCBCES Coin Hopper is EMPTY or JAMMED! No coin dispensed for 5 seconds..."

#### ⚠️ Hardware Safety Protection Rationale

High-torque coin hopper motors are designed to operate under intermittent load. Allowing a hopper to spin dry indefinitely when empty will cause motor overheating, plastic gear wear, and unfulfilled payouts. The 5-second cutoff ensures complete mechanical safety while alerting the operator immediately via cellular SMS.

💬

Serial Monitor Testing & Verification Protocol

Upload 08_coin_hopper_gsm_low_coin_test.ino to your Arduino Uno and open the Serial Monitor at 115200 baud:

Serial Input | Test Scenario | Expected Behavior
1 | Normal Payout (3 Coins / ₱3.00) | Relay starts motor, dispenses 3 coins, counts pulses on D7, stops cleanly, and beeps twice.
2 | Extended Payout (20 Coins / ₱20.00) | Dispenses 20 coins continuously for 1.5L bottle mode test.
1 (with empty hopper) | Low-Coin / Jam Simulation | Motor runs for exactly 5.0 seconds. With no coins passing D7, motor cuts off, buzzer alarms, Red LED lights up, and SMS is sent to the admin phone!
m | Manual SMS Verification | Immediately triggers the Low-Coin alert SMS without engaging the motor to verify GSM network readiness.
s / n | Cellular Health Check | Queries signal quality (AT+CSQ) and network registration status (AT+CREG?).
