Glenn-IT/PCBCES-Plastic-Bottle-Coin-Exchanger-System/arduino/pcbces_arduino_controller/pcbces_arduino_controller.ino

/*
 * PCBCES - Master Capstone Reverse Vending Machine Controller
 * Plastic Bottle Coin Exchanger System with 3-Button UI & GSM Telemetry
 * Last Updated: 2026-09-18 23:20:00 (+08:00)
 * 
 * Hardware Architecture:
 * - Arduino Uno R3
 * - 16x2 I2C LCD (PCF8574)
 * - 3 Dedicated Control Buttons (INPUT_PULLUP):
 *     * Button Green (Pin 10): 1.5L / 1.75L Bottle Mode (5 pcs = 20 PHP)
 *     * Button Blue  (Pin A0): 290 ML Bottle Mode (10 pcs = 3 PHP)
 *     * Button Red   (Pin A1): System Restart / Cancel Transaction
 * - Active 5V Buzzer & Green/Red Status LEDs
 * - HC-SR04+ Ultrasonic (Bottle Length / Size Discrimination)
 * - IR Obstacle Avoidance (Bottle Insertion Beam Trigger)
 * - LJ12A3 Inductive Sensor (Metallic Object Rejection)
 * - MG996R Metal Gear Servo (Accept/Reject Trapdoor Flap)
 * - 220V/12V Coin Hopper & 5V Relay (20.00 PHP or 3.00 PHP Payout)
 * - SIM900A / SIM800L GSM Module (Storage Bin Full SMS Telemetry on 5VT->D11, 5VR<-A3)
 * - Pin D5: IR Bin-Full Sensor (Active LOW: 10-Second continuous debounce trigger for SMS alert)
 */

#include <Wire.h>
#include <LiquidCrystal_I2C.h>
#include <Servo.h>
#include <SoftwareSerial.h>
#include "config.h"

// Hardware Instances
LiquidCrystal_I2C lcd(0x27, 16, 2);
Servo trapdoor;
SoftwareSerial gsm(PIN_GSM_RX, PIN_GSM_TX);

// State Machine Definition
enum MachineState {
  STATE_STANDBY_MENU,
  STATE_WAIT_INSERTION,
  STATE_VALIDATE_BOTTLE,
  STATE_ACCEPT_DROP,
  STATE_REJECT_EJECT,
  STATE_PAYOUT_COINS,
  STATE_BIN_FULL_LOCKED
};

MachineState currentState = STATE_STANDBY_MENU;
enum BottleType { TYPE_1_5L, TYPE_290ML };
const BottleType TYPE_MISMO = TYPE_290ML; // Backward compatibility alias
BottleType selectedType = TYPE_1_5L;

int currentDepositCount = 0;
int requiredQuota = BOTTLE_1_5L_QUOTA;
int requiredCoinsPayout = COINS_PAYOUT_1_5L;
int totalBinBottles = 0;
volatile int coinsDispensed = 0;
unsigned long binBlockedStartTime = 0;

// Coin Pulse state tracking
int lastCoinPinState = HIGH;

// Sound Helpers
void soundBeep(int ms = 80) {
  digitalWrite(PIN_BUZZER, HIGH);
  delay(ms);
  digitalWrite(PIN_BUZZER, LOW);
}

void soundError() {
  for (int i = 0; i < 3; i++) {
    digitalWrite(PIN_BUZZER, HIGH);
    digitalWrite(PIN_LED_RED, HIGH);
    delay(100);
    digitalWrite(PIN_BUZZER, LOW);
    digitalWrite(PIN_LED_RED, LOW);
    delay(80);
  }
}

void soundSuccess() {
  soundBeep(100); delay(60); soundBeep(180);
}

// Ultrasonic reading (Vertical Top-Down: Ceiling Sensor to Bottle Cap)
// 5-sample median filter with 30ms acoustic decay to eliminate internal chamber echo ringing
long singlePingChamber() {
  digitalWrite(PIN_ULTRASONIC_TRIG, LOW);
  delayMicroseconds(4);
  digitalWrite(PIN_ULTRASONIC_TRIG, HIGH);
  delayMicroseconds(10);
  digitalWrite(PIN_ULTRASONIC_TRIG, LOW);

  // 6000us timeout = ~102 cm max range (prevents listening to stray wall reflections)
  long duration = pulseIn(PIN_ULTRASONIC_ECHO, HIGH, 6000);
  if (duration <= 0) return CHAMBER_TOTAL_HEIGHT_CM;
  long cm = duration * 0.034 / 2;
  if (cm < 2 || cm > 60) return CHAMBER_TOTAL_HEIGHT_CM;
  return cm;
}

long readChamberDistance() {
  const int NUM_SAMPLES = 5;
  long samples[NUM_SAMPLES];

  for (int i = 0; i < NUM_SAMPLES; i++) {
    samples[i] = singlePingChamber();
    delay(30); // 30ms inter-ping acoustic dissipation delay
  }

  // Insertion sort to extract true median
  for (int i = 1; i < NUM_SAMPLES; i++) {
    long key = samples[i];
    int j = i - 1;
    while (j >= 0 && samples[j] > key) {
      samples[j + 1] = samples[j];
      j--;
    }
    samples[j + 1] = key;
  }

  return samples[NUM_SAMPLES / 2];
}

// GSM SMS Alerts
void sendRawSMS(const char* phoneNumber, const char* message) {
  gsm.println("AT+CMGF=1");
  delay(400);
  gsm.print("AT+CMGS=\"");
  gsm.print(phoneNumber);
  gsm.println("\"");
  delay(400);
  gsm.print(message);
  delay(400);
  gsm.write(26); // Ctrl+Z
  delay(3000);
}

void sendBinFullSMS() {
  Serial.println(F("[GSM] Sending Bin-Full Alert to Admin Phones..."));
  char msg[140];
  snprintf(msg, sizeof(msg), "ALERT: PCBCES Storage Bin is FULL (%d bottles / IR Beam Blocked)! Machine is locked. Please empty bin.", totalBinBottles);
  sendRawSMS(ADMIN_PHONE_1, msg);
  delay(2000);
  sendRawSMS(ADMIN_PHONE_2, msg);
  Serial.println(F("[GSM] Bin-Full SMS command executed for all admins."));
}

void sendLowCoinSMS() {
  Serial.println(F("[GSM] Sending Low/Empty Coin Alert to Admin Phones..."));
  const char* msg = "ALERT: PCBCES Coin Hopper is EMPTY or LOW ON COINS! Dispense timed out. Please refill 1-peso coins.";
  sendRawSMS(ADMIN_PHONE_1, msg);
  delay(2000);
  sendRawSMS(ADMIN_PHONE_2, msg);
  Serial.println(F("[GSM] Low-Coin SMS command executed for all admins."));
}

void showMenuLCD() {
  lcd.clear();
  lcd.setCursor(0, 0);
  lcd.print("GRN:1.5L BLU:290");
  lcd.setCursor(0, 1);
  lcd.print("RED:Cancel/Reset");
}

void showProgressLCD() {
  lcd.clear();
  lcd.setCursor(0, 0);
  if (selectedType == TYPE_1_5L) {
    lcd.print("1.5L/1.75L(5pcs)");
  } else {
    lcd.print("290 ML  (10 pcs)");
  }
  lcd.setCursor(0, 1);
  lcd.print("Count: ");
  lcd.print(currentDepositCount);
  lcd.print("/");
  lcd.print(requiredQuota);
  lcd.print(" [RED:X]");
}

// Red Button: Cancel Transaction & Return to Standby
bool checkCancelButton() {
  if (digitalRead(PIN_BTN_RED) == LOW) {
    delay(50); // debounce
    if (digitalRead(PIN_BTN_RED) == LOW) {
      Serial.println(F("[SYSTEM] Red Button Pressed: Transaction Cancelled / Restarting..."));
      soundBeep(250);
      lcd.clear();
      lcd.setCursor(0, 0);
      lcd.print(" TRANSACTION    ");
      lcd.setCursor(0, 1);
      lcd.print(" CANCELLED / RST");
      delay(1500);
      currentDepositCount = 0;
      currentState = STATE_STANDBY_MENU;
      showMenuLCD();
      while (digitalRead(PIN_BTN_RED) == LOW); // wait for release
      return true;
    }
  }
  return false;
}

void setup() {
  Serial.begin(115200);
  gsm.begin(9600);

  // Auto-baud sync for GSM modem (SIM900A / SIM800L)
  delay(1000);
  gsm.println("AT");
  delay(200);
  gsm.println("AT");

  // 3 Dedicated Buttons (Internal Pullups to GND)
  pinMode(PIN_BTN_GREEN, INPUT_PULLUP);
  pinMode(PIN_BTN_BLUE, INPUT_PULLUP);
  pinMode(PIN_BTN_RED, INPUT_PULLUP);

  // Sensors & Actuators
  pinMode(PIN_IR_ENTRY, INPUT);
  pinMode(PIN_IR_BIN_FULL, INPUT); // IR Obstacle Sensor at Top of Bottle Storage Bin (Active LOW)
  pinMode(PIN_IND_METAL, INPUT);
  pinMode(PIN_COIN_PULSE, INPUT_PULLUP);
  pinMode(PIN_ULTRASONIC_TRIG, OUTPUT);
  pinMode(PIN_ULTRASONIC_ECHO, INPUT);
  
  pinMode(PIN_RELAY_HOPPER, OUTPUT);
  digitalWrite(PIN_RELAY_HOPPER, HIGH); // Relay OFF (Active LOW relay)

  pinMode(PIN_BUZZER, OUTPUT);
  pinMode(PIN_LED_RED, OUTPUT);
  pinMode(PIN_LED_GREEN, OUTPUT);

  digitalWrite(PIN_BUZZER, LOW);
  digitalWrite(PIN_LED_RED, LOW);
  digitalWrite(PIN_LED_GREEN, LOW);

  // Servo Setup
  trapdoor.attach(PIN_SERVO_TRAPDOOR);
  trapdoor.write(SERVO_STANDBY_ANGLE);

  // LCD Setup
  lcd.init();
  lcd.backlight();
  lcd.setCursor(0, 0);
  lcd.print(" PCBCES SYSTEM  ");
  lcd.setCursor(0, 1);
  lcd.print(" 3-Button Ready ");
  soundBeep(120);

  delay(1200);
  showMenuLCD();
  Serial.println(F("[MASTER] PCBCES Fully Initialized with 3 Dedicated Buttons:"));
  Serial.println(F(" - GREEN (D10): 1.5L Mode"));
  Serial.println(F(" - BLUE  (A0):  Mismo Mode"));
  Serial.println(F(" - RED   (A1):  System Restart / Cancel"));
}

void loop() {
  // --- IR SENSOR BIN FULL CONTINUOUS MONITORING (PIN D5) ---
  // If the IR sensor is triggered (Active LOW) and STAYS triggered continuously for 10 SECONDS (10000ms),
  // lock the system and dispatch automated emergency SMS to admins.
  if (digitalRead(PIN_IR_BIN_FULL) == LOW) {
    if (binBlockedStartTime == 0) {
      binBlockedStartTime = millis();
      Serial.println(F("[BIN SENSOR] IR Bin-Full Sensor (D5) triggered. Starting 10-second timer..."));
    } else if (millis() - binBlockedStartTime >= BIN_FULL_HOLD_TIME_MS) {
      if (currentState != STATE_BIN_FULL_LOCKED) {
        Serial.println(F("\n[BIN ALERT] Physical IR Bin-Full Sensor blocked for 10 seconds! Storage bin is full."));
        currentState = STATE_BIN_FULL_LOCKED;
      }
    }
  } else {
    if (binBlockedStartTime != 0 && currentState != STATE_BIN_FULL_LOCKED) {
      Serial.println(F("[BIN SENSOR] Object cleared before 10s elapsed. Timer reset."));
      binBlockedStartTime = 0;
    }
  }

  switch (currentState) {
    case STATE_STANDBY_MENU: {
      digitalWrite(PIN_LED_GREEN, HIGH);
      digitalWrite(PIN_LED_RED, LOW);

      // 1. GREEN BUTTON -> Select 1.5L / 1.75L Mode (5 pcs = 20 PHP)
      if (digitalRead(PIN_BTN_GREEN) == LOW) {
        delay(50);
        if (digitalRead(PIN_BTN_GREEN) == LOW) {
          selectedType = TYPE_1_5L;
          requiredQuota = BOTTLE_1_5L_QUOTA;
          requiredCoinsPayout = COINS_PAYOUT_1_5L;
          currentDepositCount = 0;
          soundBeep(100);
          Serial.println(F("[MENU] GREEN pressed: 1.5L / 1.75L Mode Selected (5 pcs = 20 PHP)"));
          
          lcd.clear();
          lcd.setCursor(0, 0);
          lcd.print("MODE: 1.5L/1.75L");
          lcd.setCursor(0, 1);
          lcd.print("Target: 5 (20P) ");
          delay(1000);
          
          currentState = STATE_WAIT_INSERTION;
          showProgressLCD();
          while (digitalRead(PIN_BTN_GREEN) == LOW);
          break;
        }
      }

      // 2. BLUE BUTTON -> Select 290 ML Mode (10 pcs = 3 PHP)
      if (digitalRead(PIN_BTN_BLUE) == LOW) {
        delay(50);
        if (digitalRead(PIN_BTN_BLUE) == LOW) {
          selectedType = TYPE_290ML;
          requiredQuota = BOTTLE_290ML_QUOTA;
          requiredCoinsPayout = COINS_PAYOUT_290ML;
          currentDepositCount = 0;
          soundBeep(100);
          Serial.println(F("[MENU] BLUE pressed: 290 ML Mode Selected (10 pcs = 3 PHP)"));
          
          lcd.clear();
          lcd.setCursor(0, 0);
          lcd.print("MODE: 290 ML PET");
          lcd.setCursor(0, 1);
          lcd.print("Target: 10 (3P) ");
          delay(1000);
          
          currentState = STATE_WAIT_INSERTION;
          showProgressLCD();
          while (digitalRead(PIN_BTN_BLUE) == LOW);
          break;
        }
      }

      // 3. RED BUTTON -> Reset Standby Menu
      if (digitalRead(PIN_BTN_RED) == LOW) {
        delay(50);
        if (digitalRead(PIN_BTN_RED) == LOW) {
          soundBeep(150);
          currentDepositCount = 0;
          Serial.println(F("[MENU] RED pressed: Standby Refreshed / Reset."));
          showMenuLCD();
          while (digitalRead(PIN_BTN_RED) == LOW);
          break;
        }
      }
      break;
    }

    case STATE_WAIT_INSERTION: {
      // Check if user pressed RED button to cancel/restart transaction
      if (checkCancelButton()) break;

      // Check IR Entry Sensor
      if (digitalRead(PIN_IR_ENTRY) == LOW) {
        // Bottle detected in entry chute!
        lcd.clear();
        lcd.setCursor(0, 0);
        lcd.print("BOTTLE DETECTED ");
        lcd.setCursor(0, 1);
        lcd.print("Align Bottle 2s ");
        soundBeep(70);
        delay(1000);

        lcd.setCursor(0, 1);
        lcd.print("Scanning in 1s..");
        delay(1000);

        lcd.setCursor(0, 1);
        lcd.print("Scanning Sensors");
        currentState = STATE_VALIDATE_BOTTLE;
      }
      break;
    }

    case STATE_VALIDATE_BOTTLE: {
      Serial.println(F("[VALIDATION] Commencing multi-sensor verification..."));

      // 1. Metal Rejection Check (LJ12A3 Inductive Sensor)
      // Active LOW when metal is detected
      bool isMetal = (digitalRead(PIN_IND_METAL) == LOW);
      if (isMetal) {
        Serial.println(F("[VALIDATION] REJECT: Metallic object detected!"));
        currentState = STATE_REJECT_EJECT;
        break;
      }

      // 2. Dimensional Vertical Distance Check (HC-SR04 Ultrasonic at Ceiling)
      // Measures distance from ceiling down to the bottle cap to verify correct size
      long distToCap = readChamberDistance();
      long computedBottleHeight = (CHAMBER_TOTAL_HEIGHT_CM > distToCap) ? (CHAMBER_TOTAL_HEIGHT_CM - distToCap) : 0;
      Serial.print(F("[VALIDATION] Top-to-Cap Distance: "));
      Serial.print(distToCap);
      Serial.print(F(" cm (Approx Bottle Height: "));
      Serial.print(computedBottleHeight);
      Serial.println(F(" cm)"));

      bool validDimensions = false;
      if (selectedType == TYPE_1_5L && distToCap >= DIST_1_5L_MIN && distToCap <= DIST_1_5L_MAX) {
        validDimensions = true;
      } else if (selectedType == TYPE_290ML && distToCap >= DIST_290ML_MIN && distToCap <= DIST_290ML_MAX) {
        validDimensions = true;
      }

      if (!validDimensions) {
        Serial.print(F("[VALIDATION] REJECT: Bottle dimensions mismatch for "));
        Serial.println((selectedType == TYPE_1_5L) ? F("1.5L / 1.75L Mode") : F("290 ML Mode"));
        currentState = STATE_REJECT_EJECT;
        break;
      }

      // All criteria passed!
      Serial.println(F("[VALIDATION] PASSED: Valid plastic bottle verified."));
      currentState = STATE_ACCEPT_DROP;
      break;
    }

    case STATE_ACCEPT_DROP: {
      Serial.println(F("[TRAPDOOR] Opening flap (90 deg) to accept bottle..."));
      lcd.clear();
      lcd.setCursor(0, 0);
      lcd.print("BOTTLE ACCEPTED!");
      digitalWrite(PIN_LED_GREEN, HIGH);
      soundSuccess();

      trapdoor.write(SERVO_ACCEPT_ANGLE);
      delay(1500); // Allow bottle to slide into lower collection bin
      trapdoor.write(SERVO_STANDBY_ANGLE);
      delay(500);

      currentDepositCount++;
      totalBinBottles++;

      // Check Bin Capacity: either bottle quota limit OR physical IR beam blocked at top of bin
      bool binSensorBlocked = (digitalRead(PIN_IR_BIN_FULL) == LOW);
      if (totalBinBottles >= MAX_BIN_CAPACITY || binSensorBlocked) {
        Serial.print(F("[BIN ALERT] "));
        if (binSensorBlocked) Serial.println(F("Physical IR Bin-Full Beam Blocked!"));
        else Serial.println(F("Software Max Capacity Reached!"));
        currentState = STATE_BIN_FULL_LOCKED;
        break;
      }

      if (currentDepositCount >= requiredQuota) {
        currentState = STATE_PAYOUT_COINS;
      } else {
        showProgressLCD();
        currentState = STATE_WAIT_INSERTION;
      }
      break;
    }

    case STATE_REJECT_EJECT: {
      Serial.println(F("[TRAPDOOR] Rejection triggered: Flap holds at 0 deg (Item remains on cradle for manual removal)."));
      lcd.clear();
      lcd.setCursor(0, 0);
      lcd.print("BOTTLE REJECTED!");
      lcd.setCursor(0, 1);
      lcd.print("Pls Remove Item ");
      soundError();

      // Flap remains firmly at 0 deg (Closed cradle position)
      trapdoor.write(SERVO_STANDBY_ANGLE);

      // Flash Red LED and wait until user removes the rejected item from cradle
      unsigned long rejectStart = millis();
      while (digitalRead(PIN_IR_ENTRY) == LOW && (millis() - rejectStart < 6000)) {
        digitalWrite(PIN_LED_RED, HIGH);
        delay(200);
        digitalWrite(PIN_LED_RED, LOW);
        delay(200);
      }
      digitalWrite(PIN_LED_RED, LOW);
      delay(500);

      showProgressLCD();
      currentState = STATE_WAIT_INSERTION;
      break;
    }

    case STATE_PAYOUT_COINS: {
      Serial.print(F("[PAYOUT] Quota reached! Dispensing "));
      Serial.print(requiredCoinsPayout);
      Serial.println(F(".00 PHP..."));
      lcd.clear();
      lcd.setCursor(0, 0);
      lcd.print("QUOTA REACHED!  ");
      lcd.setCursor(0, 1);
      if (requiredCoinsPayout >= 10) {
        lcd.print("Dispensing 20PHP");
      } else {
        lcd.print("Dispensing 3 PHP");
      }

      coinsDispensed = 0;
      digitalWrite(PIN_RELAY_HOPPER, LOW); // Start Hopper Motor (220V AC / 12V DC)
      delay(50); // Settle electrical inrush transient

      unsigned long payoutStart = millis();
      unsigned long payoutTimeout = (unsigned long)requiredCoinsPayout * 2500UL + 6000UL;
      unsigned long lastEdgeTime = millis();
      int lastEdgeState = digitalRead(PIN_COIN_PULSE);

      while (coinsDispensed < requiredCoinsPayout) {
        int curState = digitalRead(PIN_COIN_PULSE);
        if (curState != lastEdgeState) {
          unsigned long now = millis();
          // Mask noise within first 150ms of payout and require 35ms pulse separation
          if (curState == LOW && (now - payoutStart > 100) && (now - lastEdgeTime > 35)) {
            coinsDispensed++;
            lastEdgeTime = now;
          }
          lastEdgeState = curState;
        }

        if (millis() - payoutStart > payoutTimeout) {
          Serial.println(F("[PAYOUT ERROR] Hopper timeout: Low coins / Empty hopper detected!"));
          break;
        }
        delay(2);
      }

      digitalWrite(PIN_RELAY_HOPPER, HIGH); // Stop Hopper Motor

      if (coinsDispensed < requiredCoinsPayout) {
        // Hopper is empty or jammed!
        soundError();
        lcd.clear();
        lcd.setCursor(0, 0);
        lcd.print("LOW/NO COINS!   ");
        lcd.setCursor(0, 1);
        lcd.print("CALL ADMIN      ");
        
        // Trigger automated SMS to machine owner
        sendLowCoinSMS();
        delay(4000);
      } else {
        // Payout successfully completed
        soundSuccess();
        lcd.clear();
        lcd.setCursor(0, 0);
        lcd.print("PAYOUT COMPLETE!");
        lcd.setCursor(0, 1);
        lcd.print("Thank You! :)   ");
        delay(3000);
      }

      currentDepositCount = 0;
      currentState = STATE_STANDBY_MENU;
      showMenuLCD();
      break;
    }

    case STATE_BIN_FULL_LOCKED: {
      Serial.println(F("[ALERT] Storage Bin is Full. System Locked."));
      digitalWrite(PIN_RELAY_HOPPER, HIGH);
      trapdoor.write(SERVO_STANDBY_ANGLE);
      digitalWrite(PIN_LED_RED, HIGH);
      digitalWrite(PIN_LED_GREEN, LOW);

      lcd.clear();
      lcd.setCursor(0, 0);
      lcd.print("BIN IS FULL!    ");
      lcd.setCursor(0, 1);
      lcd.print("SENDING SMS...  ");
      soundError();

      sendBinFullSMS();

      lcd.clear();
      lcd.setCursor(0, 0);
      lcd.print("BIN IS FULL!    ");
      lcd.setCursor(0, 1);
      lcd.print("HOLD RED: RESET ");

      // Press RED button for 2 seconds to restart after emptying bin
      while (true) {
        if (digitalRead(PIN_BTN_RED) == LOW) {
          unsigned long holdStart = millis();
          bool longPressed = false;
          while (digitalRead(PIN_BTN_RED) == LOW) {
            if (millis() - holdStart >= 2000) {
              longPressed = true;
              break;
            }
            delay(50);
          }

          if (longPressed) {
            if (digitalRead(PIN_IR_BIN_FULL) == LOW) {
              soundError();
              lcd.clear();
              lcd.setCursor(0, 0);
              lcd.print("BIN STILL FULL! ");
              lcd.setCursor(0, 1);
              lcd.print("Empty bin first!");
              Serial.println(F("[RESET FAIL] Cannot reset: Physical IR Bin-Full Sensor is still blocked!"));
              delay(2000);
              lcd.clear();
              lcd.setCursor(0, 0);
              lcd.print("BIN IS FULL!    ");
              lcd.setCursor(0, 1);
              lcd.print("HOLD RED: RESET ");
            } else {
              totalBinBottles = 0;
              currentDepositCount = 0;
              binBlockedStartTime = 0;
              soundSuccess();
              lcd.clear();
              lcd.setCursor(0, 0);
              lcd.print("SYSTEM RESET OK ");
              lcd.setCursor(0, 1);
              lcd.print("Resuming Normal ");
              delay(1500);
              currentState = STATE_STANDBY_MENU;
              showMenuLCD();
              while (digitalRead(PIN_BTN_RED) == LOW);
              return;
            }
          }
        }
        delay(50);
      }
      break;
    }
  }
}
