Glenn-IT/PCBCES-Plastic-Bottle-Coin-Exchanger-System/arduino/06_coin_hopper_relay_test/06_coin_hopper_relay_test.ino

/*
 * PCBCES - Test 06: Coin Hopper & 5V Relay Payout Test
 * Hardware: Arduino Uno, 5V Relay Module, 220V/12V Coin Hopper, YT LP-08 A01 Sensor Board
 * Last Updated: 2026-09-07 17:42:00 (+08:00)
 * 
 * Clean Edge-Detection Polling (No PCINT / No Serial Ghost Triggering)
 * 
 * Objectives:
 * - Accurately detect each coin pulse as it passes the optical sensor
 * - Dispense 3 coins (₱3.00 for 290 ML quota)
 * - Dispense 20 coins (₱20.00 for 1.5L/1.75L quota)
 * - 5-Second Motor Auto-Cutoff: If no coin is detected for 5 seconds (hopper empty/jammed),
 *   automatically stops the motor to protect hardware from running dry.
 */

const int RELAY_PIN = 8;
const int COIN_PULSE_PIN = 7;
const unsigned long COIN_TIMEOUT_MS = 5000; // 5-second safety cutoff if no coins detected

volatile int coinsDispensed = 0;
int currentTargetCoins = 3;
bool isDispensing = false;

int lastPinState = -1;
unsigned long lastPulseTime = 0;
unsigned long payoutStartTime = 0;

void startPayout(int target) {
  currentTargetCoins = target;
  coinsDispensed = 0;
  
  Serial.println();
  Serial.print(F(">>> STARTING PAYOUT: Target = "));
  Serial.print(target);
  Serial.print(F(" Coins ("));
  Serial.print(target);
  Serial.println(F(".00 PHP)"));
  Serial.println(F(">>> Relay ON -> Waiting for coins..."));

  // Turn Relay ON (Active LOW)
  digitalWrite(RELAY_PIN, LOW);
  payoutStartTime = millis();
  isDispensing = true;

  // Let electrical turn-on noise settle, then latch baseline pin state
  delay(50);
  lastPinState = digitalRead(COIN_PULSE_PIN);
  lastPulseTime = millis();
}

void stopPayout() {
  // Cut power to hopper motor
  digitalWrite(RELAY_PIN, HIGH);
  isDispensing = false;

  Serial.println();
  Serial.println(F("=================================================="));
  Serial.print(F(">>> PAYOUT COMPLETE! Total Coins Counted: "));
  Serial.println(coinsDispensed);
  Serial.println(F(">>> Relay OFF -> Motor Stopped."));
  Serial.println(F("=================================================="));
  Serial.println(F("Send '1' to dispense 3 coins, or '2' to dispense 20 coins:"));
}

void timeoutPayout() {
  // Cut power to hopper motor due to timeout (no coins detected)
  digitalWrite(RELAY_PIN, HIGH);
  isDispensing = false;

  Serial.println();
  Serial.println(F("=================================================="));
  Serial.println(F(">>> [TIMEOUT ALERT] NO COINS DETECTED FOR 5 SECONDS!"));
  Serial.println(F(">>> Hopper is EMPTY, low on coins, or jammed."));
  Serial.print(F(">>> Motor stopped automatically. Coins Dispensed: "));
  Serial.print(coinsDispensed);
  Serial.print(F(" / "));
  Serial.println(currentTargetCoins);
  Serial.println(F(">>> (Note: In Master Controller, this triggers Low-Coin SMS to Admin)"));
  Serial.println(F("=================================================="));
  Serial.println(F("Refill coins, then send '1' (3 coins) or '2' (20 coins):"));
}

void setup() {
  Serial.begin(115200);
  
  pinMode(RELAY_PIN, OUTPUT);
  digitalWrite(RELAY_PIN, HIGH); // Relay OFF at startup

  pinMode(COIN_PULSE_PIN, INPUT_PULLUP);
  lastPinState = digitalRead(COIN_PULSE_PIN);

  Serial.println(F("=================================================="));
  Serial.println(F(" PCBCES Test 06: Coin Hopper Payout Testing       "));
  Serial.println(F(" Hardware: Pin D8 (Relay) | Pin D7 (Coin Pulse)  "));
  Serial.println(F("=================================================="));
  Serial.print(F("Initial Pin D7 State: "));
  Serial.println(lastPinState == HIGH ? F("HIGH") : F("LOW"));
  Serial.println(F("Drop a coin through the sensor now to test detection!"));
  Serial.println(F("Commands:"));
  Serial.println(F(" '1' or 'd' -> Dispense 3 Coins  (3.00 PHP - 290 ML Quota)"));
  Serial.println(F(" '2'        -> Dispense 20 Coins (20.00 PHP - 1.5L/1.75L Quota)"));
  Serial.println(F("--------------------------------------------------"));
}

void loop() {
  // Read Pin 7 state
  int currentPinState = digitalRead(COIN_PULSE_PIN);

  // Detect FALLING edge only (HIGH -> LOW as coin enters & breaks the IR beam)
  if (lastPinState == HIGH && currentPinState == LOW) {
    unsigned long now = millis();

    // 35ms debounce: prevents optical ring bounce while ensuring fast coins are not skipped
    // Also ignore any pulse within the first 150ms of motor turn-on (relay inrush noise)
    bool startupNoise = isDispensing && (now - payoutStartTime < 150);

    if (!startupNoise && (now - lastPulseTime > 35)) {
      coinsDispensed++;
      lastPulseTime = now;

      Serial.print(F("--> [COIN DETECTED!] Count = "));
      Serial.print(coinsDispensed);

      if (isDispensing) {
        Serial.print(F(" / "));
        Serial.println(currentTargetCoins);

        if (coinsDispensed >= currentTargetCoins) {
          stopPayout();
        }
      } else {
        Serial.println(F(" (Manual drop test)"));
      }
    }
  }
  lastPinState = currentPinState;

  // 5-Second Auto-Cutoff: Stop motor if no coins detected for 5 seconds
  if (isDispensing && (millis() - lastPulseTime >= COIN_TIMEOUT_MS)) {
    timeoutPayout();
  }

  // Handle Serial Commands
  if (Serial.available()) {
    char ch = Serial.read();
    if (ch == '\r' || ch == '\n' || ch == ' ') return;

    if (!isDispensing) {
      if (ch == '1' || ch == 'd' || ch == 'D') {
        startPayout(3);
      } else if (ch == '2') {
        startPayout(20);
      }
    } else {
      if (ch == 'x' || ch == 'X' || ch == 's' || ch == 'S') {
        Serial.println(F(">>> EMERGENCY STOP!"));
        stopPayout();
      }
    }
  }
}
