Glenn-IT/PCBCES-Plastic-Bottle-Coin-Exchanger-System/(commit log)

2026-09-04 Add PCBCES project plan, wiring guides, and modular Arduino test suites
2026-09-04 Update pinouts, calibration, and add chassis 3D design documentation with renders
2026-09-04 Add 3-button navigation support, updated wiring diagrams, and kiosk 3-button render
2026-09-05 Update full system circuit schematic, 20-pin matrix, and modular hardware hub
2026-09-05 Update system architecture to 40cm vertical drop chamber with top-down ultrasonic bottle profiling
2026-09-06 feat: omit LJC18A3 capacitive sensor, reallocate D5 as spare GPIO, and synchronize all hardware guides
2026-09-06 Calibrate chamber height to 43cm, add acoustic dissipation median filter, and update firmware timestamps
2026-09-06 Update Mismo detection range to 24-27cm across firmware and documentation
2026-09-06 Add real chassis calibration guides (notetest03.md and notetest_other_hardware.md) and update system memory
2026-09-06 Enhance Test 04 wiring guide with LJ12A3 wire color coding, resistor divider schematic, and detailed bench testing instructions
2026-09-06 Support 10k/5k resistor divider (4.00V) alongside 10k/4.7k across wiring guides, firmware, and calibration notes
2026-09-06 Enhance Test 05 wiring guide with 1000uF 50V capacitor guidance, detailed schematic, and sorting angles
2026-09-06 Update trapdoor servo logic: 0 deg standby and reject hold, 90 deg accept drop across repository
2026-09-06 Update bottle modes across repository: 1.5L/1.75L (5 pcs = 20 PHP) and 290 ML (10 pcs = 3 PHP)
2026-09-06 Upgrade Test 06 wiring guide to ultra-detailed Test 04 structure and interactive schematic
2026-09-06 Fix coin counting interrupt for Pin 7 with Pin Change Interrupt (PCINT23) and fast edge polling
    [06_coin_hopper_relay_test.ino, pcbces_arduino_controller.ino]
2026-09-06 Fix double counting: trigger exclusively on falling edge (HIGH to LOW) with 60ms debounce
    [06_coin_hopper_relay_test.ino]
2026-09-06 Synchronize hardware specs and wiring guides across repo for 220V AC coin hopper and 5V sensor
2026-09-06 Fix coin hopper timing: add 150ms startup noise mask and 35ms debounce to prevent missing coin
    [06_coin_hopper_relay_test.ino, pcbces_arduino_controller.ino]
2026-09-06 Add IR Bin-Full Sensor on Pin D5 and smart Low/Empty Coin timeout alert to master system
2026-09-07 feat(hardware): sync 290ML distance 26-27cm, add demo chassis controller, 5s hopper auto-cutoff
2026-09-07 feat(ux): add 2-second alignment delay with countdown on LCD before scanning sensors
2026-09-18 feat(calibration): sync Test 03 chamber height 31cm and bottle ranges (1.5L 11-12cm, 290ML 23-24cm) across repo
2026-09-18 feat(demo): update demo chassis test with GSM SMS, comment out metal sensor, and disable damaged servo for manual removal
    [pcbces_demo_chassis_test.ino]
2026-09-18 feat(demo): enable IR entry/bin-full sensors and integrate Test 08 GSM low-coin alerts with calibrated 32cm height
2026-09-18 feat(hardware): implement Pin D5 IR bin-full 10s trigger & SMS, comment out metal sensor in demo rig, sync all controllers
2026-09-19 IR sensor
2026-09-27 feat(hardware): calibrate and sync MG995 360-degree continuous servo timed control (650ms)
2026-09-27 fix(servo): detach continuous servo when stationary to prevent SoftwareSerial/GSM interrupt jitter
    [05_mg996r_servo_trapdoor_test.ino, pcbces_demo_chassis_test.ino]
2026-09-27 feat(servo): calibrate trapdoor opening and closing duration to 900ms
